abnlsn/EE31-Project/Arduino-UNO-R4-Shield-Template-main/3DModels/1x9.STEP

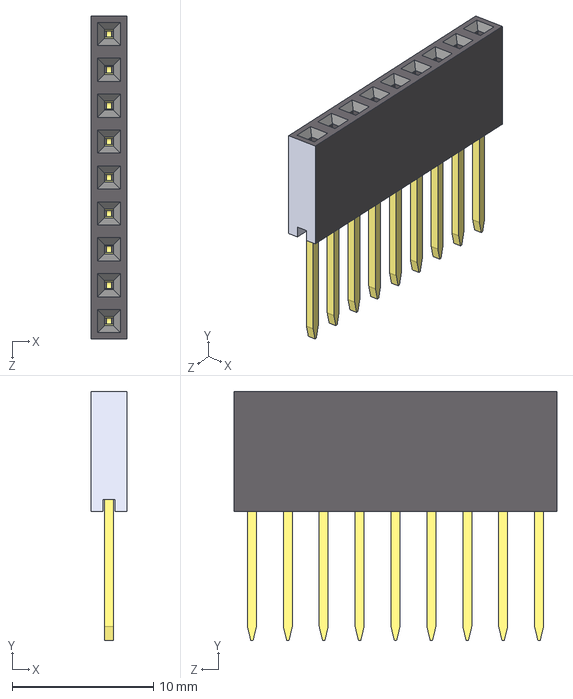
[picture p1: CAD file, 2024-12-06]
Arduino-UNO-R4-Shield-Template-main/3DModels/1x9.STEP
2.54 x 17.6 x 22.9 mm
