abnlsn/EE31-Project/Bot_CAD_files/Color_detection_shield.stl

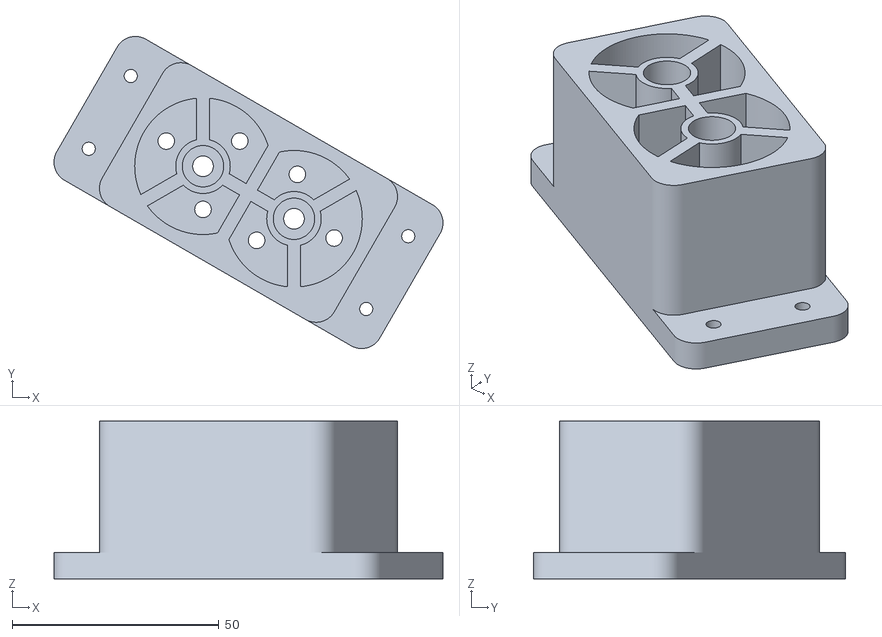
[picture p2: CAD file, 2024-12-18]
Bot_CAD_files/Color_detection_shield.stl
94.1 x 75.5 x 38.1
