abnlsn/EE31-Project/Bot_CAD_files/Collision_detection_shield.stl

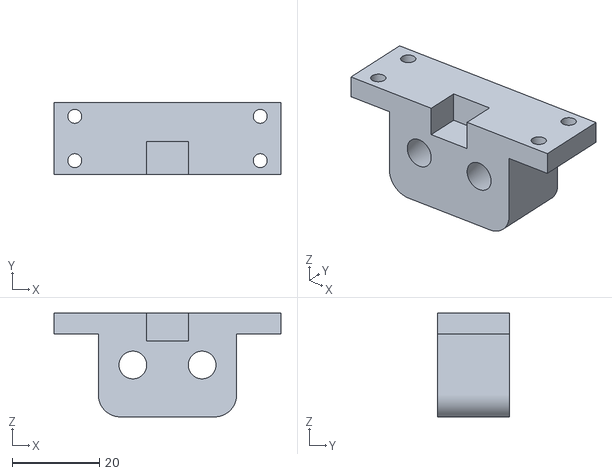
[picture p4: CAD file, 2024-12-18]
Bot_CAD_files/Collision_detection_shield.stl
52.1 x 16.5 x 23.8
