abnlsn/EE31-Project/Arduino-UNO-R4-Shield-Template-main/3DModels/1x5.STEP

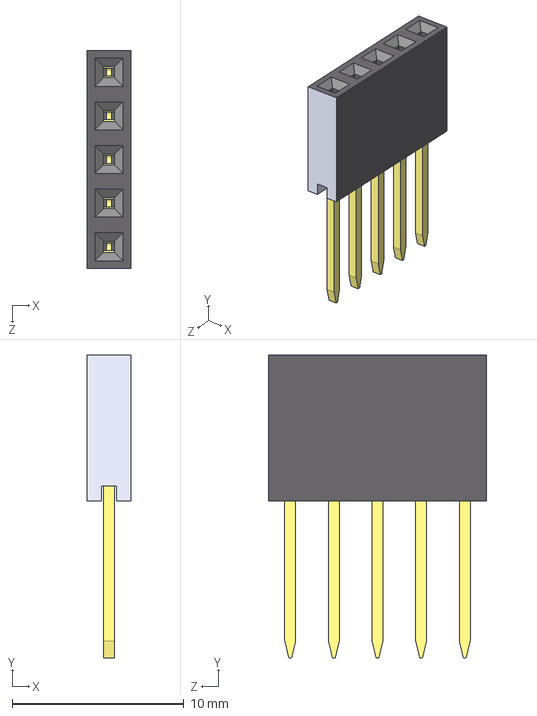
[picture p5: CAD file, 2024-12-06]
Arduino-UNO-R4-Shield-Template-main/3DModels/1x5.STEP
2.54 x 17.6 x 12.7 mm
