abnlsn/EE31-Project/Bot_CAD_files/Omni_directional_wheel_spacer.stl

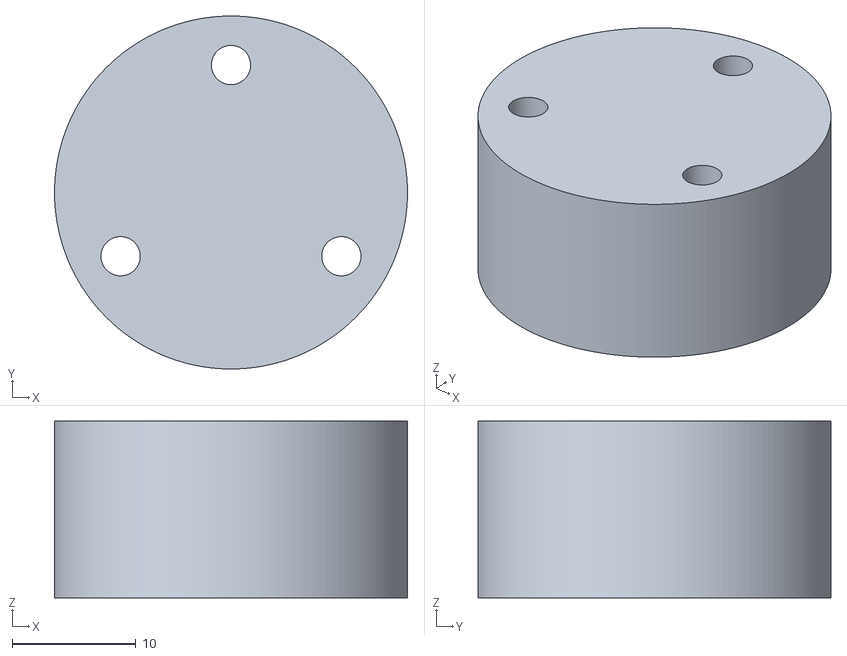
[picture p6: CAD file, 2024-12-18]
Bot_CAD_files/Omni_directional_wheel_spacer.stl
28.6 x 28.6 x 14.3
