abnlsn/EE31-Project/Arduino-UNO-R4-Shield-Template-main/3DModels/1x4.STEP

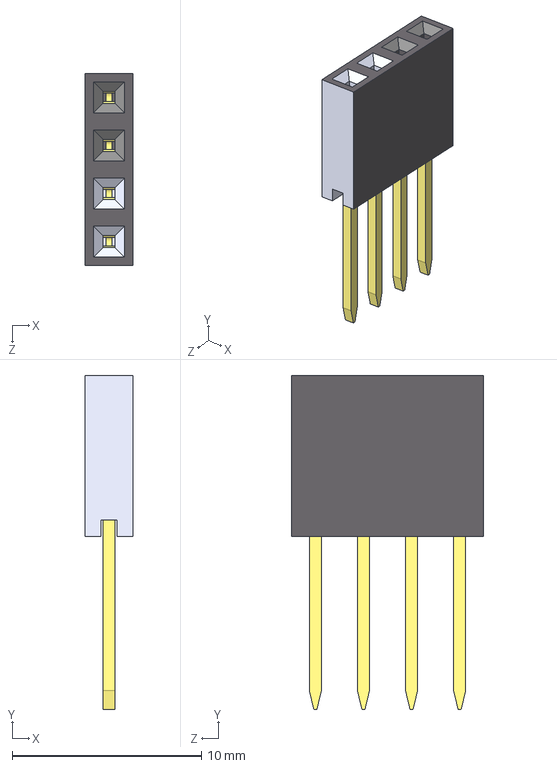
[picture p7: CAD file, 2024-12-06]
Arduino-UNO-R4-Shield-Template-main/3DModels/1x4.STEP
2.54 x 17.6 x 10.2 mm
