abnlsn/EE31-Project/Bot_CAD_files/Chassis.stl

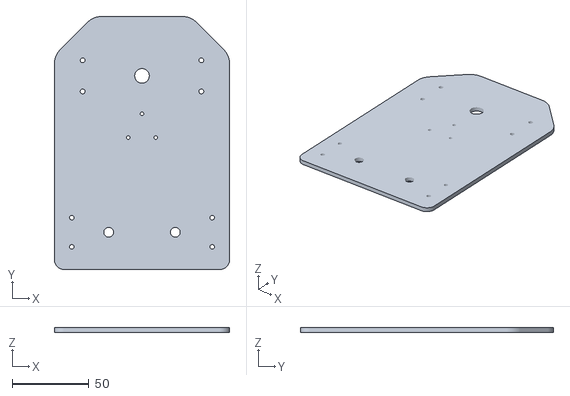
[picture p8: CAD file, 2024-12-18]
Bot_CAD_files/Chassis.stl
114.3 x 165.1 x 3.00
