abnlsn/EE31-Project/Arduino-UNO-R4-Shield-Template-main/3DModels/pin header female 2.54mm_0.1in.STEP

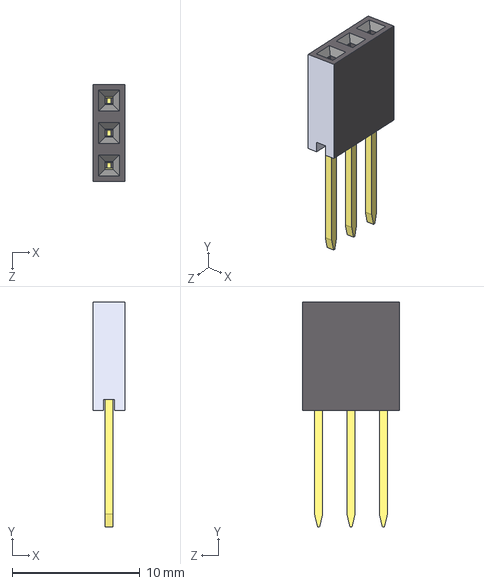
[picture p10: CAD file, 2024-12-06]
Arduino-UNO-R4-Shield-Template-main/3DModels/pin header female 2.54mm_0.1in.STEP
2.54 x 17.6 x 7.62 mm
