abnlsn/EE31-Project/Arduino-UNO-R4-Shield-Template-main/3DModels/1x2.STEP

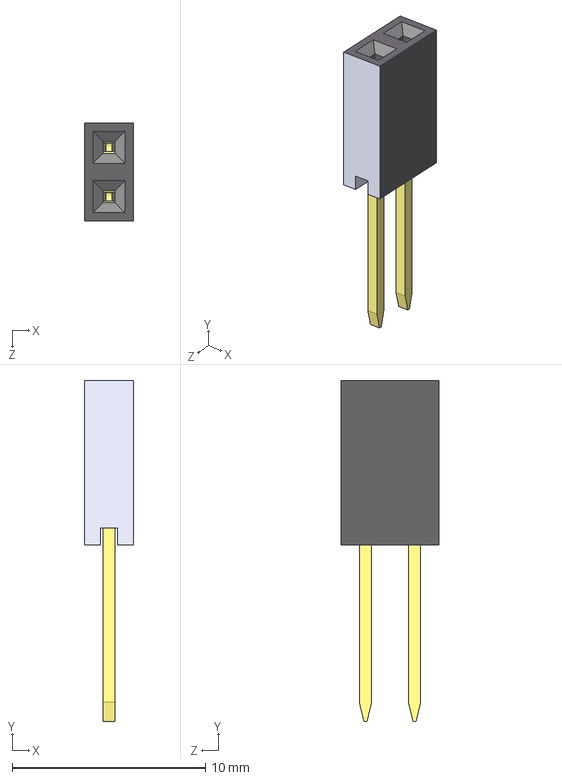
[picture p11: CAD file, 2024-12-06]
Arduino-UNO-R4-Shield-Template-main/3DModels/1x2.STEP
2.54 x 17.6 x 5.08 mm
