abnlsn/EE31-Project/Arduino-UNO-R4-Shield-Template-main/3DModels/1x6.STEP

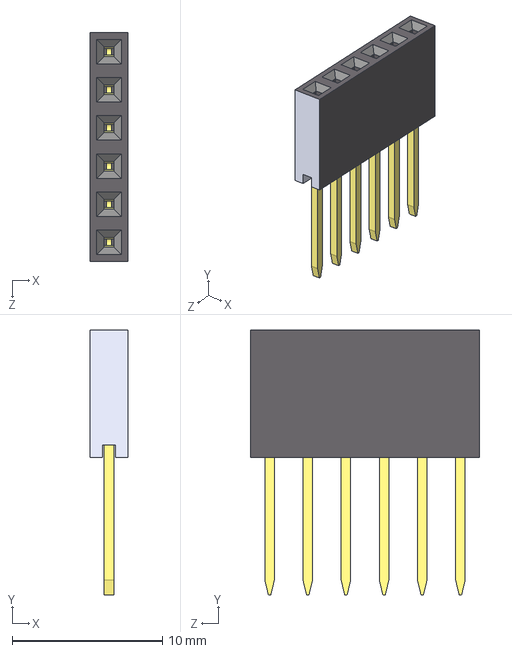
[picture p12: CAD file, 2024-12-06]
Arduino-UNO-R4-Shield-Template-main/3DModels/1x6.STEP
2.54 x 17.6 x 15.2 mm
