abnlsn/EE31-Project/(list of files, cad)

Other CAD files:
Arduino-UNO-R4-Shield-Template-main/3DModels/pin_header_female_2.54mm_0.1in.STEP
Bot_CAD_files/Chassis.dxf
