abnlsn/EE31-Project/Arduino-UNO-R4-Shield-Template-main/ArduinoUnoR4Shield.kicad_pcb

## KiCad design Arduino-UNO-R4-Shield-Template-main/ArduinoUnoR4Shield.kicad_pcb (2024-12-18)

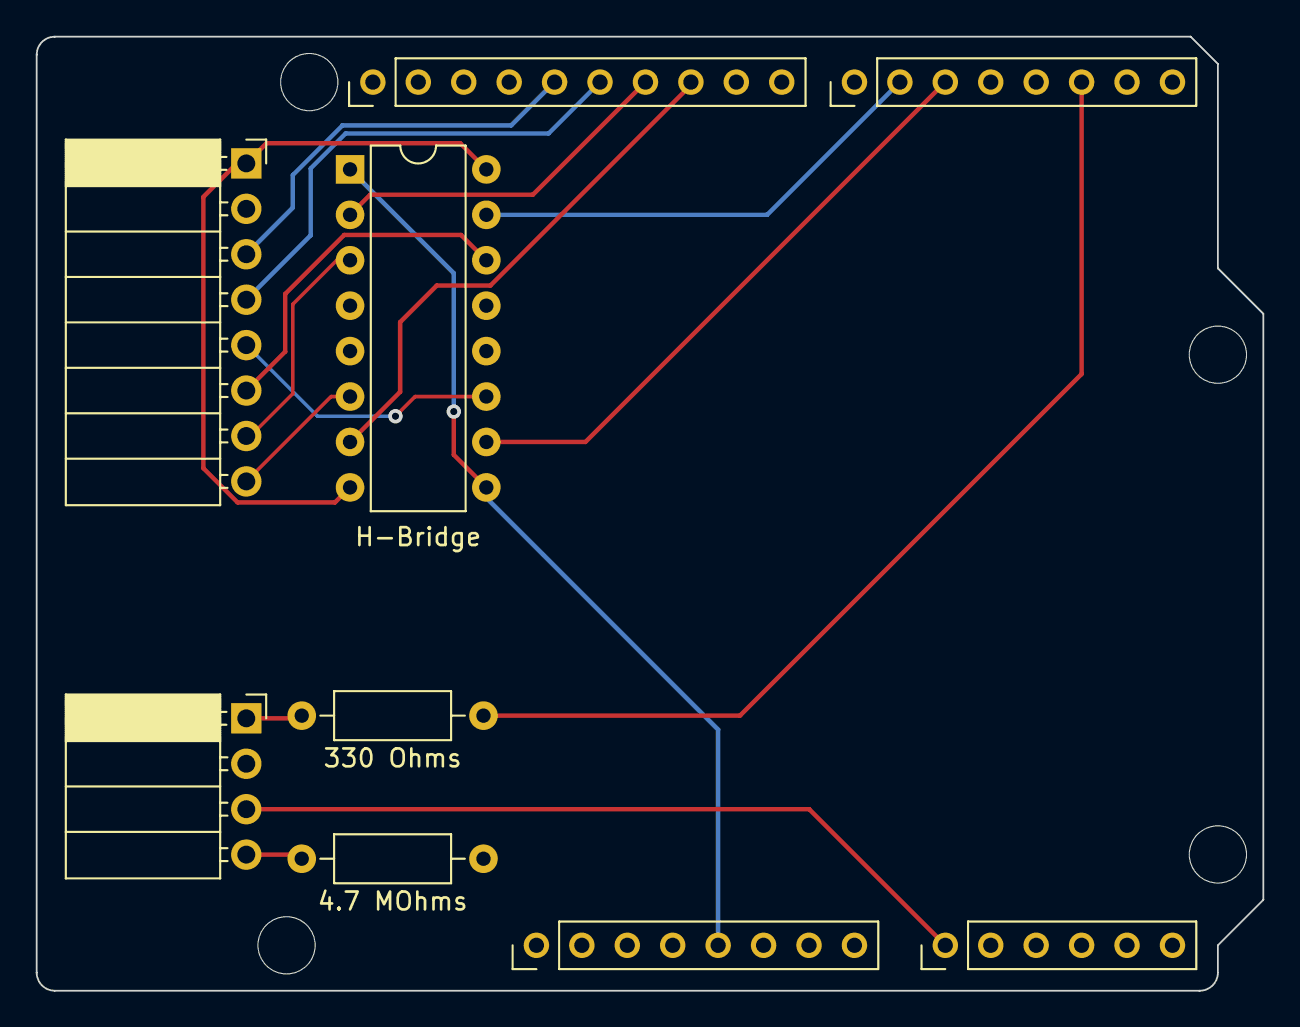
[picture p13: board ArduinoUnoR4Shield.kicad_pcb from above]

Board: 2 copper layers, 68.6 x 53.3 mm, 13 parts (0 on the bottom side), 17 nets.

Parts:
4.7 MOhms: 4.7 MOhms; R_Axial_DIN0207_L6.3mm_D2.5mm_P10.16mm_Horizontal
330 Ohms: 330 Ohms; R_Axial_DIN0207_L6.3mm_D2.5mm_P10.16mm_Horizontal
H1: MountingHole1; Arduino_MountingHole
H2: MountingHole2; Arduino_MountingHole
H3: MountingHole3; Arduino_MountingHole
H4: MountingHole4; Arduino_MountingHole
H-Bridge: L293; DIP-16_W7.62mm
J1: Conn_01x08_Socket; PinSocket_1x08_P2.54mm_Horizontal
J2: Conn_01x04_Socket; PinSocket_1x04_P2.54mm_Horizontal
U2: Analog_1; Arduino_PinSocket_1x08_P2.54mm_Vertical
U3: Analog_2; Arduino_PinSocket_1x06_P2.54mm_Vertical
U6: Digital_1; Arduino_PinSocket_1x10_P2.54mm_Vertical
U7: Digital_2; Arduino_PinSocket_1x08_P2.54mm_Vertical

Connections:
5V: H-Bridge.1 (EN1,2), H-Bridge.9 (EN3,4), U2.5 (+5V)
6V: H-Bridge.8 (VCC2), H-Bridge.16 (VCC1), J1.1
GND: 4.7 MOhms.1, H-Bridge.4 (GND), H-Bridge.5 (GND), H-Bridge.12 (GND), H-Bridge.13 (GND), J1.2, J2.2, U2.7 (GND)
L encoder: J1.4, U6.6 (D12/CIPO)
L motor 1: H-Bridge.2 (1A), U6.7 (~D11/COPI)
L motor 2: H-Bridge.7 (2A), U6.8 (~D10/CS/CANTX0)
unnamed: 330 Ohms.2, J2.1
unnamed: J2.3, U3.9 (A0)
unnamed: 4.7 MOhms.2, J2.4
unnamed: 330 Ohms.1, U7.16 (D2)
R encoder: J1.3, U6.5 (D13/SCK/CANRX0)
R motor 1: H-Bridge.10 (3A), U7.13 (~D5)
R motor 2: H-Bridge.15 (4A), U7.12 (~D6)
left motor +: H-Bridge.3 (1Y), J1.7
left motor -: H-Bridge.6 (2Y), J1.8
right motor +: H-Bridge.11 (3Y), J1.5
right motor -: H-Bridge.14 (4Y), J1.6
