abnlsn/EE31-Project/MotorSpeedControl/MotorSpeedControl.ino

/*
* Authors: Abe Nelson, Eric M. Rohloff
* Date: 11/21/2024
* 
* Main Entry Point of the code, responsible for running through server 
* communication, motor control, and the state machine 
*/
#include "motor_speed.h"
#include "sensing.h"
#include "state_machine.h"
#include "wifi_client.h"

void setup() {
  Serial.begin(9600);
  motorspeed_setup();
  sensing_setup();
  statemachine_setup();

  delay(100);
}

void loop() {
  Serial.println("");
  motorspeed_loop();
  sensing_loop();
  statemachine_run();

  delay(50);
}
