abnlsn/EE31-Project/(commit log)

2024-09-12 Basic H_bridge PWM code
2024-09-26 HTTP requests momentarily not working, will fix
    [WiFiWebClient.ino]
2024-10-01 Added dynamic url based on UUIDs in arduino_secrets.h
2024-10-15 Copied motor drive code into sketch
2024-10-17 Rudimentary motor straightening working
2024-10-22 Added motor dependent calibration values
2024-10-29 Fixed duty cycle problems with right motor
    [motor_calibration.h, motor_speed.ino]
2024-10-31 Updated pins to use PWM
2024-11-14 Working on motor safety
2024-11-21 Got rotation working in the motorspeed state machine
2024-11-26 Added rotation constants, still need to calibrate
2024-12-14 Switched motors for left turns
2024-12-16 Updating calibration values from remote_control branch
2024-12-18 Cleaning up repo
    [ArduinoUnoR4Shield.kicad_pcb]
2024-12-18 CAD Files
    Added CAD files
    [Chassis.stl, Collision_detection_shield.stl, Color_detection_shield.stl, Omni_directional_wheel_spacer.stl]
